icanc0/cm4-VS035ZSM-driver/cm4-VS035ZSM-driver.kicad_pcb

## KiCad design cm4-VS035ZSM-driver.kicad_pcb (2026-06-07)

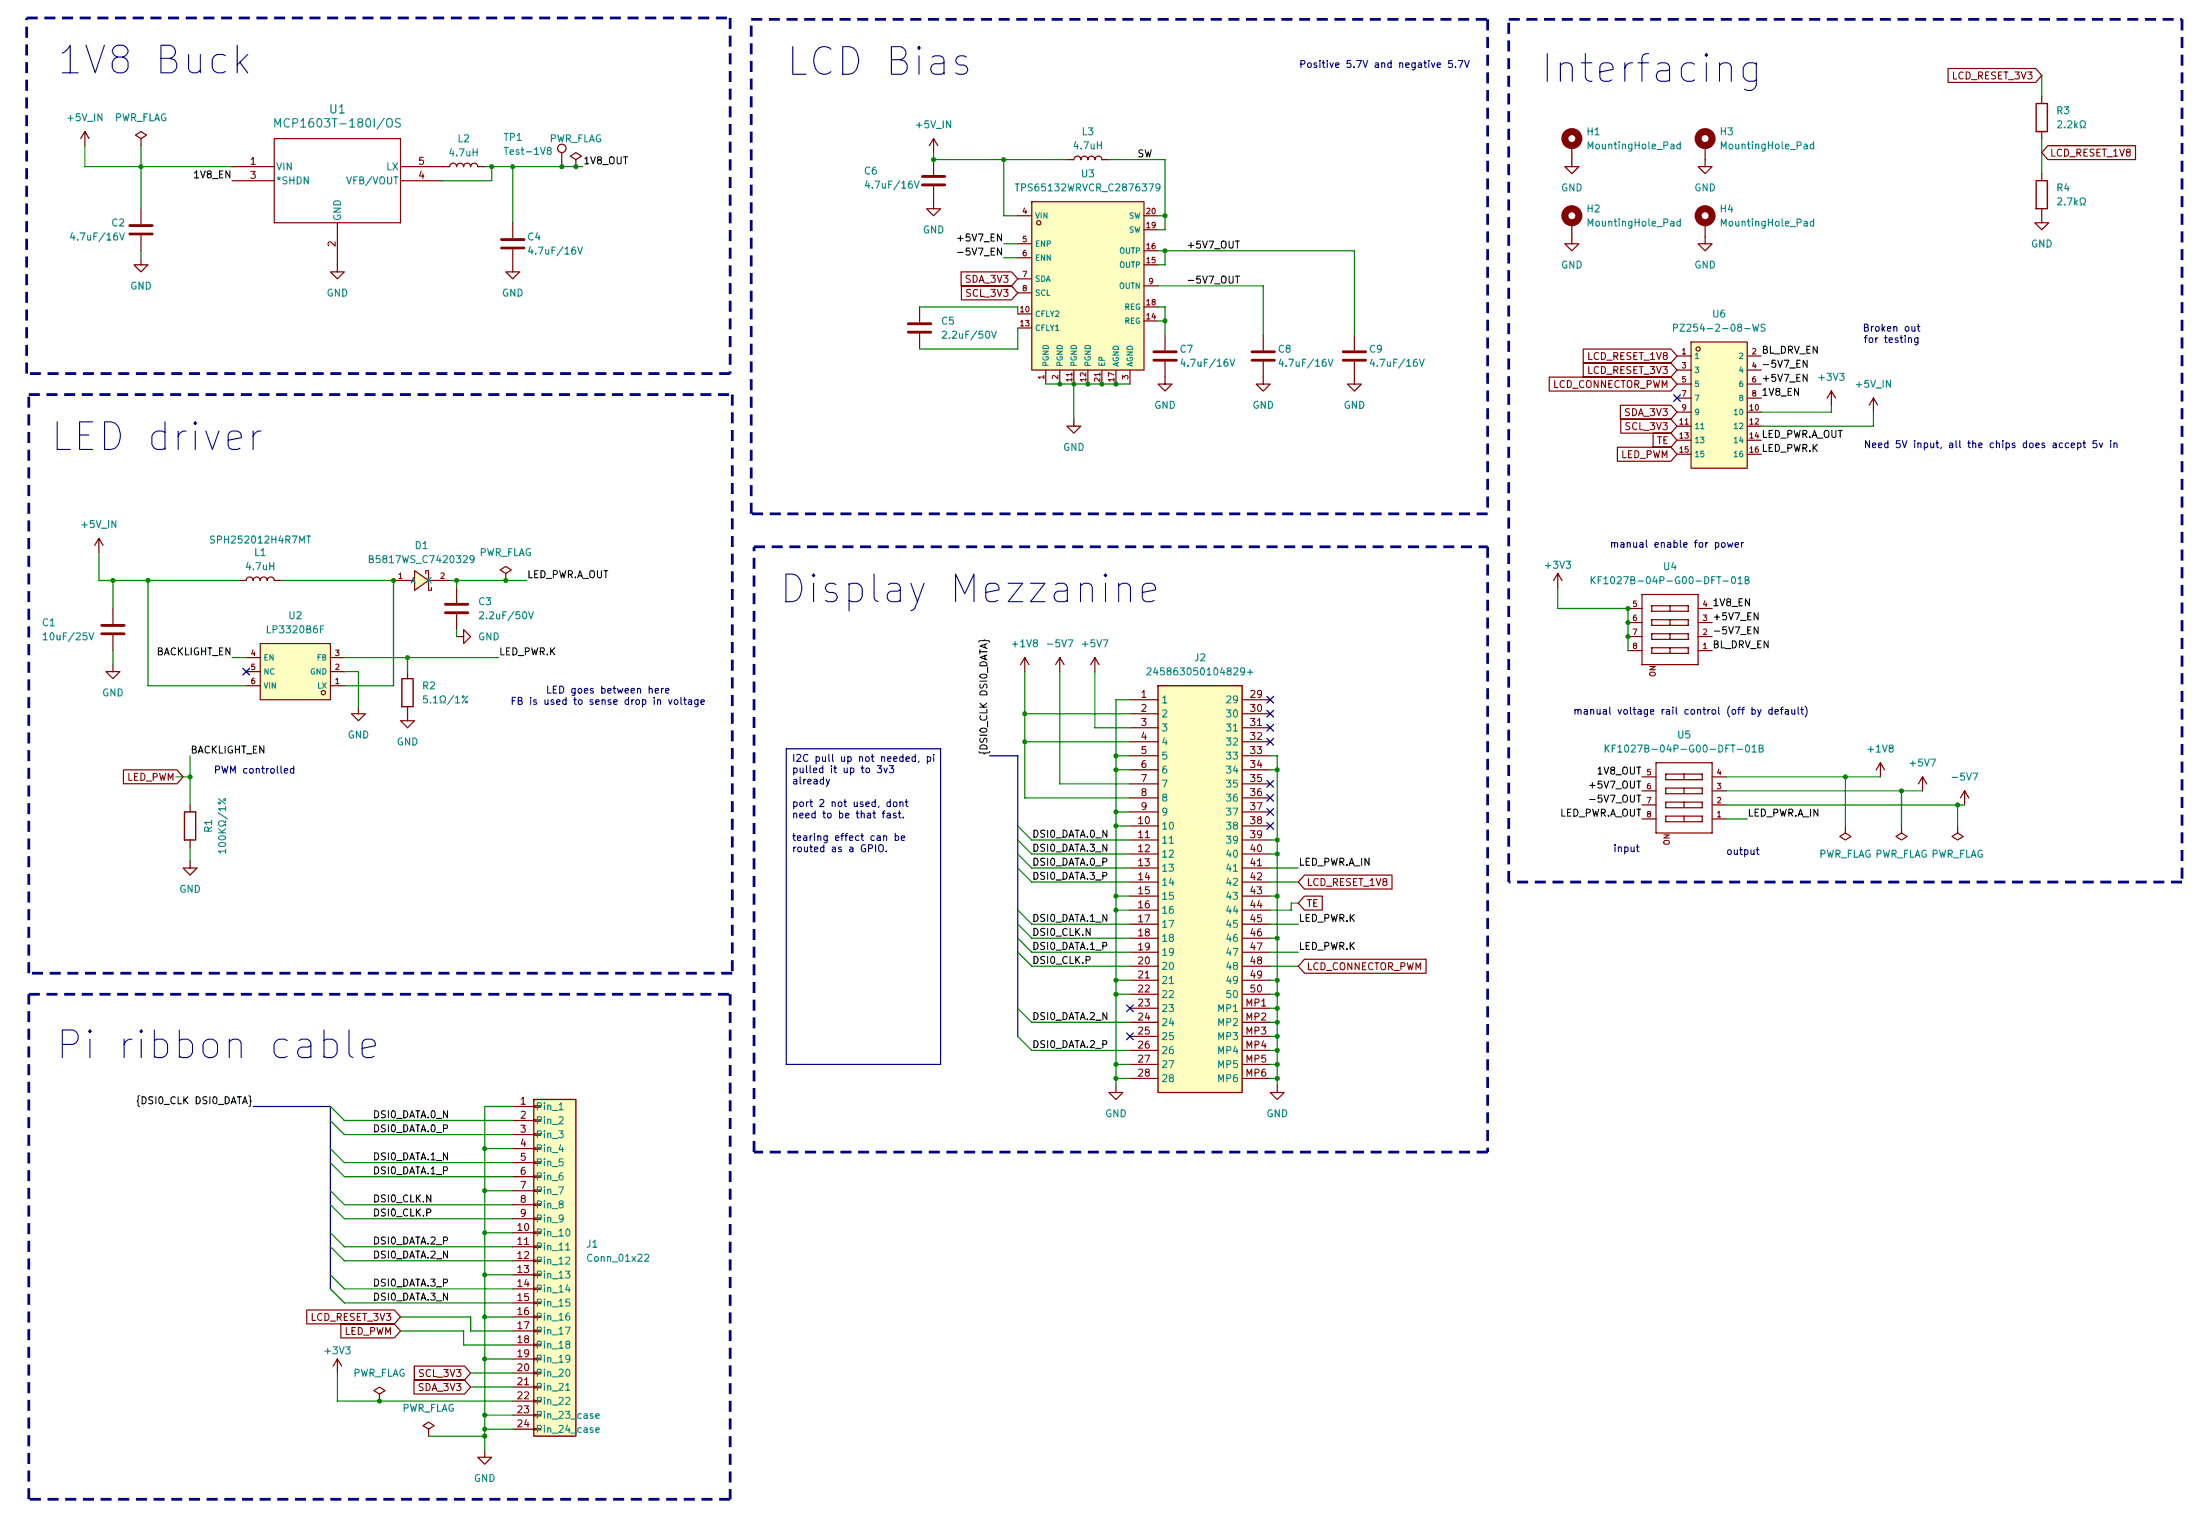
[picture p1: schematic cm4-VS035ZSM-driver.kicad_sch]

Parts:
C1: 10uF/25V; C_0603_1608Metric
C2, C4, C6, C7, C8, C9: 4.7uF/16V; C_0603_1608Metric
C3, C5: 2.2uF/50V; C_0805_2012Metric
D1: B5817WS_C7420329; SOD-323_L1.7-W1.3-LS2.5-FD; LCSC C7420329
H1, H2, H3, H4: MountingHole_Pad; MountingHole_3.2mm_M3_DIN965_Pad_TopBottom
J1: Conn_01x22; CON22_1X22_DRB_XF2C_TYC
J2: 245863050104829+; 245863050104829; Mouser Part Number 346-245863050104829+
L1, L2, L3: 4.7uH; IND-SMD_L2.5-W2.0_SPH252012
R1: 100KΩ/1%; R_0402_1005Metric
R2: 5.1Ω/1%; R_0805_2012Metric
R3: 2.2kΩ; R_0402_1005Metric
R4: 2.7kΩ; R_0603_1608Metric
TP1: Test-1V8; TestPoint_THTPad_D2.0mm_Drill1.0mm
U1: MCP1603T-180I/OS; TSOT5_MC_MCH
U2: LP3320B6F; SOT-23-6_L2.9-W1.6-P0.95-LS2.8-BL; LCSC C387699
U3: TPS65132WRVCR_C2876379; WQFN-20_L4.0-W3.0-P0.50-BL-EP; LCSC C2876379
U4, U5: KF1027B-04P-G00-DFT-01B; SW-SMD_KF1027B-04P-G00-DFT-01B; LCSC C976366
U6: PZ254-2-08-WS; HDR-SMD_16P-P2.54-H-M-R2-C8-W12.0-N; LCSC C5149358

Connections:
+1V8: J2.2, J2.4, J2.8, U5.4 (A4)
+3V3: J1.22, U4.5 (B4), U4.6 (B3), U4.7 (B2), U4.8 (B1), U6.10
+5V7: J2.3, U5.3 (A3)
+5V_IN: C1.2, C2.2, C6.1, L1.1, L3.1, U1.1 (VIN), U2.6 (VIN), U3.4 (VIN), U6.12
-5V7: J2.7, U5.2 (A2)
/1V8_EN: U1.3 (*SHDN), U4.4 (A4), U6.8
/1V8_OUT: C4.1, L2.2, TP1.1 (1_1), U1.4 (VFB/VOUT), U5.5 (B4)
/+5V7_EN: U3.5 (ENP), U4.3 (A3), U6.6
/+5V7_OUT: C9.1, U3.15 (OUTP), U3.16 (OUTP), U5.6 (B3)
/-5V7_EN: U3.6 (ENN), U4.2 (A2), U6.4
/-5V7_OUT: C8.1, U3.9 (OUTN), U5.7 (B2)
/BL_DRV_EN: U4.1 (A1), U6.2
/DSI0_CLK.N: J1.8, J2.18
/DSI0_CLK.P: J1.9, J2.20
/DSI0_DATA.0_N: J1.2, J2.11
/DSI0_DATA.0_P: J1.3, J2.13
/DSI0_DATA.1_N: J1.5, J2.17
/DSI0_DATA.1_P: J1.6, J2.19
/DSI0_DATA.2_N: J1.12, J2.24
/DSI0_DATA.2_P: J1.11, J2.26
/DSI0_DATA.3_N: J1.15, J2.12
/DSI0_DATA.3_P: J1.14, J2.14
/LED_PWR.A_IN: J2.41, U5.1 (A1)
/LED_PWR.A_OUT: C3.1, D1.2 (K), U5.8 (B1), U6.14
/LED_PWR.K: J2.45, J2.47, R2.1, U2.3 (FB), U6.16
/SW: L3.2, U3.19 (SW), U3.20 (SW)
GND: C1.1, C2.1, C3.2, C4.2, C6.2, C7.2, C8.2, C9.2, H1.1 (1_1), H2.1 (1_1), H3.1 (1_1), H4.1 (1_1), J1.1, J1.4, J1.7, J1.10, J1.13, J1.16, J1.19, J1.23 (Pin_23_case), J1.24 (Pin_24_case), J2.1, J2.5, J2.6, J2.9, J2.10, J2.15, J2.16, J2.21, J2.22, J2.27, J2.28, J2.33, J2.34, J2.39, J2.40, J2.43, J2.46, J2.49, J2.50, J2.MP1, J2.MP2, J2.MP3, J2.MP4, J2.MP5, J2.MP6, R1.2, R2.2, R4.2, U1.2 (GND), U2.2 (GND), U3.1 (PGND), U3.2 (PGND), U3.3 (AGND), U3.11 (PGND), U3.12 (PGND), U3.17 (AGND), U3.21 (EP)
LCD_CONNECTOR_PWM: J2.48, U6.5
LCD_RESET_1V8: J2.42, R3.2, R4.1, U6.1
LCD_RESET_3V3: J1.17, R3.1, U6.3
LED_PWM: J1.18, R1.1, U2.4 (EN), U6.15
unnamed: C7.1, U3.14 (REG), U3.18 (REG)
unnamed: D1.1 (A), L1.2, U2.1 (LX)
unnamed: L2.1, U1.5 (LX)
unnamed: C5.2, U3.13 (CFLY1)
unnamed: C5.1, U3.10 (CFLY2)
SCL_3V3: J1.20, U3.8 (SCL), U6.11
SDA_3V3: J1.21, U3.7 (SDA), U6.9
TE: J2.44, U6.13

Notes on the sheet:
manual enable for power
Display Mezzanine
Positive 5.7V and negative 5.7V
Pi ribbon cable
Broken out for testing
PWM controlled
LED driver
LED goes between here FB is used to sense drop in voltage
manual voltage rail control (off by default)
1V8 Buck
output
input
Need 5V input, all the chips does accept 5v in
Interfacing
LCD Bias
I2C pull up not needed, pi pulled it up to 3v3 already port 2 not used, dont need to be that fast. tearing effect can be routed as a GPIO.

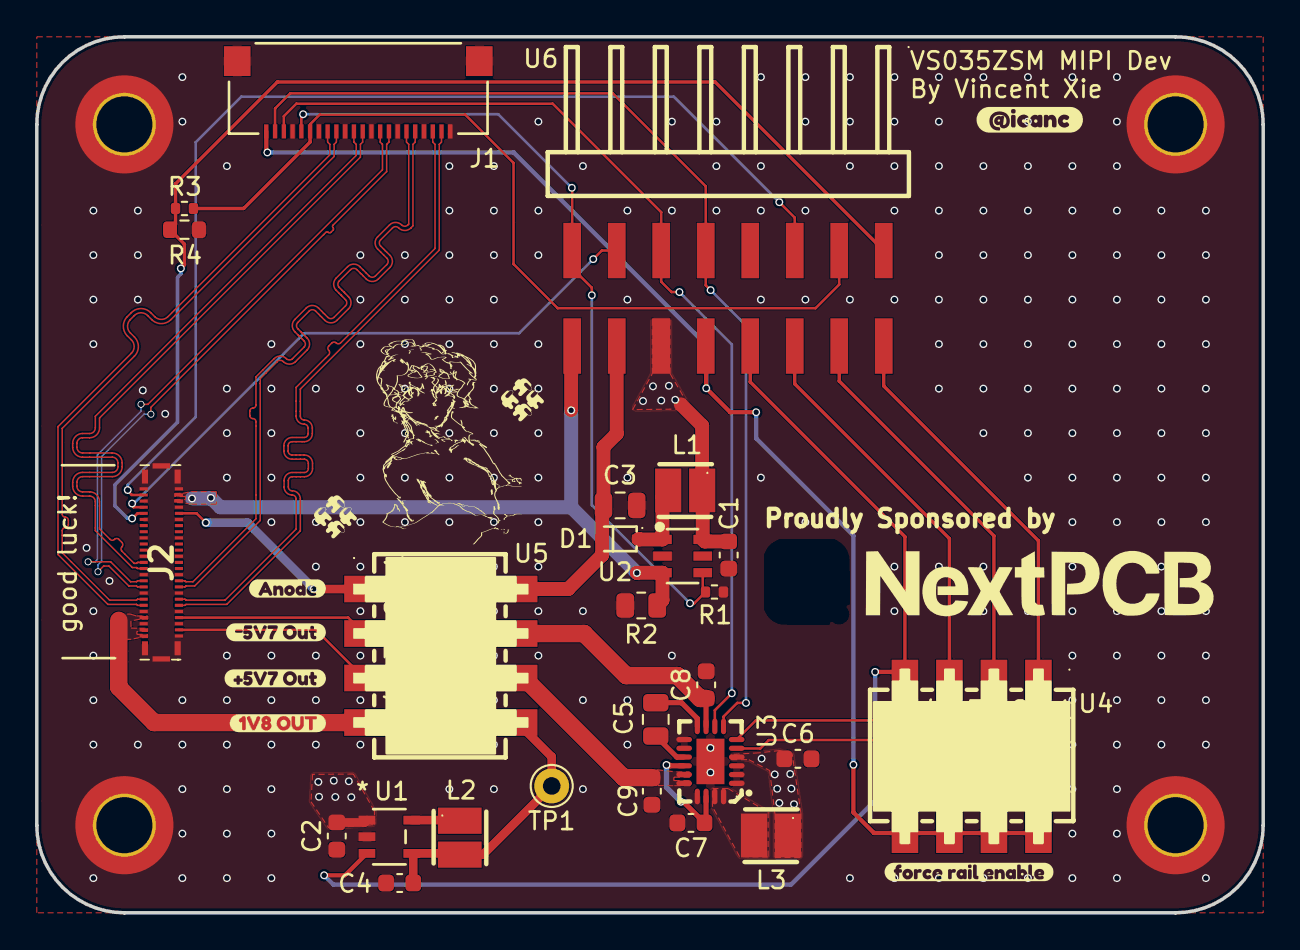
[picture p2: board cm4-VS035ZSM-driver.kicad_pcb from above]

Board: 4 copper layers, 70.0 x 50.0 mm, 36 parts (0 on the bottom side), 39 nets.

Other parts of the board:
kibuzzard-685CA5ED: G***; kibuzzard-685CA5ED
kibuzzard-685CA6CA: G***; kibuzzard-685CA6CA
kibuzzard-685CA6D3: G***; kibuzzard-685CA6D3
kibuzzard-685CA724: G***; kibuzzard-685CA724
kibuzzard-68621EB5: G***; kibuzzard-68621EB5
kibuzzard-6996886F: G***; kibuzzard-6996886F
