icanc0/cm4-VS035ZSM-driver/(commit log)

2024-09-19 progress fr
    [MIPI-screen.kicad_sch, cm4-VS035ZSM-driver.kicad_pcb, cm4-VS035ZSM-driver.kicad_sch, high-speed.kicad_sch]
2024-10-05 essential routing done
    [MIPI-screen.kicad_sch, cm4-VS035ZSM-driver.kicad_pcb, cm4-VS035ZSM-driver.kicad_sch, high-speed.kicad_sch]
2024-10-05 more routing
    [cm4-VS035ZSM-driver.kicad_sch, high-speed.kicad_sch]
2025-06-13 1v8 buck and 4.7uh inductor
    [MIPI-screen.kicad_sch, cm4-VS035ZSM-driver.kicad_pcb, cm4-VS035ZSM-driver.kicad_sch, high-speed.kicad_sch]
2025-06-26 init layout
    [MIPI-screen.kicad_sch, cm4-VS035ZSM-driver.kicad_pcb, cm4-VS035ZSM-driver.kicad_sch, high-speed.kicad_sch, references.kicad_sch]
2025-06-30 board fabbed
    [MIPI-screen.kicad_sch, cm4-VS035ZSM-driver.kicad_pcb, high-speed.kicad_sch]
2025-10-12 better driver design now that the cm5 has pin swapping support
    [cm4-VS035ZSM-driver.kicad_pcb, high-speed.kicad_sch]
2026-02-22 ok imma try kicad 10
    [cm4-VS035ZSM-driver.kicad_pcb, cm4-VS035ZSM-driver.kicad_sch]
2026-02-23 pre new revision
    [MIPI-screen.kicad_sch, high-speed.kicad_sch, references.kicad_sch]
2026-02-23 finalized board before rounding corners
    [cm4-VS035ZSM-driver-CuBottom.gbr, cm4-VS035ZSM-driver-CuIn1.gbr, cm4-VS035ZSM-driver-CuIn2.gbr, cm4-VS035ZSM-driver-CuTop.gbr, cm4-VS035ZSM-driver-EdgeCuts.gbr, cm4-VS035ZSM-driver-MaskBottom.gbr, cm4-VS035ZSM-driver-MaskTop.gbr, cm4-VS035ZSM-driver-NPTH.drl]
2026-02-23 done with v2
    [cm4-VS035ZSM-driver.kicad_pcb, cm4-VS035ZSM-driver.kicad_sch]
2026-05-21 gitignore lock files and .DS_Store
    Untrack the three ~*.kicad_*.lck files KiCad creates while a project is
    open, plus .DS_Store. Also strip the corrupted UTF-16 ". h i s t o r y"
    line from .gitignore and add explicit .history/ ignore.
2026-05-31 swap J2 connector to full-pads variant and use vias for routing
    [cm4-VS035ZSM-driver.kicad_pcb, cm4-VS035ZSM-driver.kicad_sch]
2026-06-07 update PCB, add design review notes + analysis dir
    [cm4-VS035ZSM-driver.kicad_pcb]
2026-06-12 Bump kicad-library to 5c8b195 (new header + KF1027B switch footprints)
2026-07-19 bump central kicad-library pin to 9b14e03 (post fit-pass + intake waves); local KiCad-10 resave preserved as cm4-fpc-resave.patch in scratch
